No-Chicken/OV-Card/Software/OV_CardV1/主图片.jpg

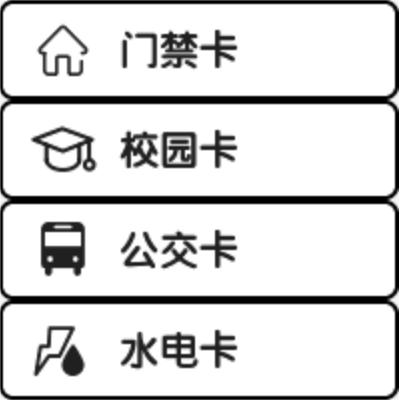
Software/OV_CardV1/主图片.jpg
