No-Chicken/OV-Card/3D Model/外壳零件.STL

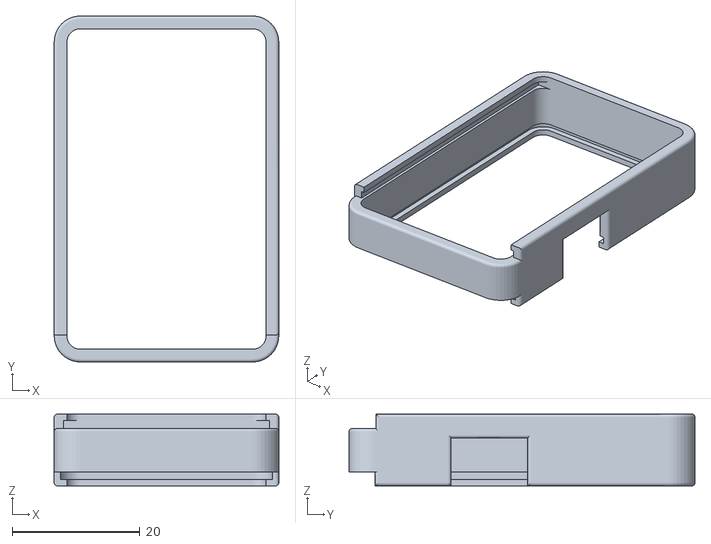
[picture p6: CAD file, 2023-08-09]
3D Model/外壳零件.STL
35.2 x 54.2 x 11.2
