No-Chicken/OV-Card/3D Model/下盖零件.STL

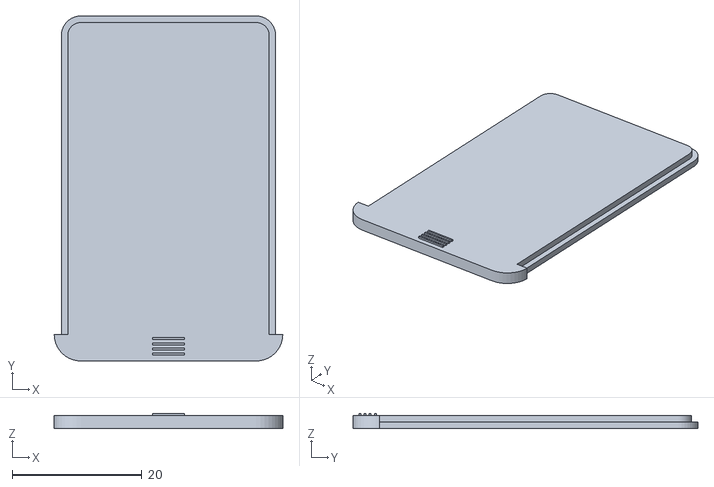
[picture p7: CAD file, 2023-08-09]
3D Model/下盖零件.STL
35.2 x 53.1 x 2.30
