No-Chicken/OV-Card/Hardware/SCH_Schematic1_2023-07-31.pdf

# VDD 17 PA8 18 PA9 19 PA10 20 PA11 21 PA12 22 PA13 23 PA14 24

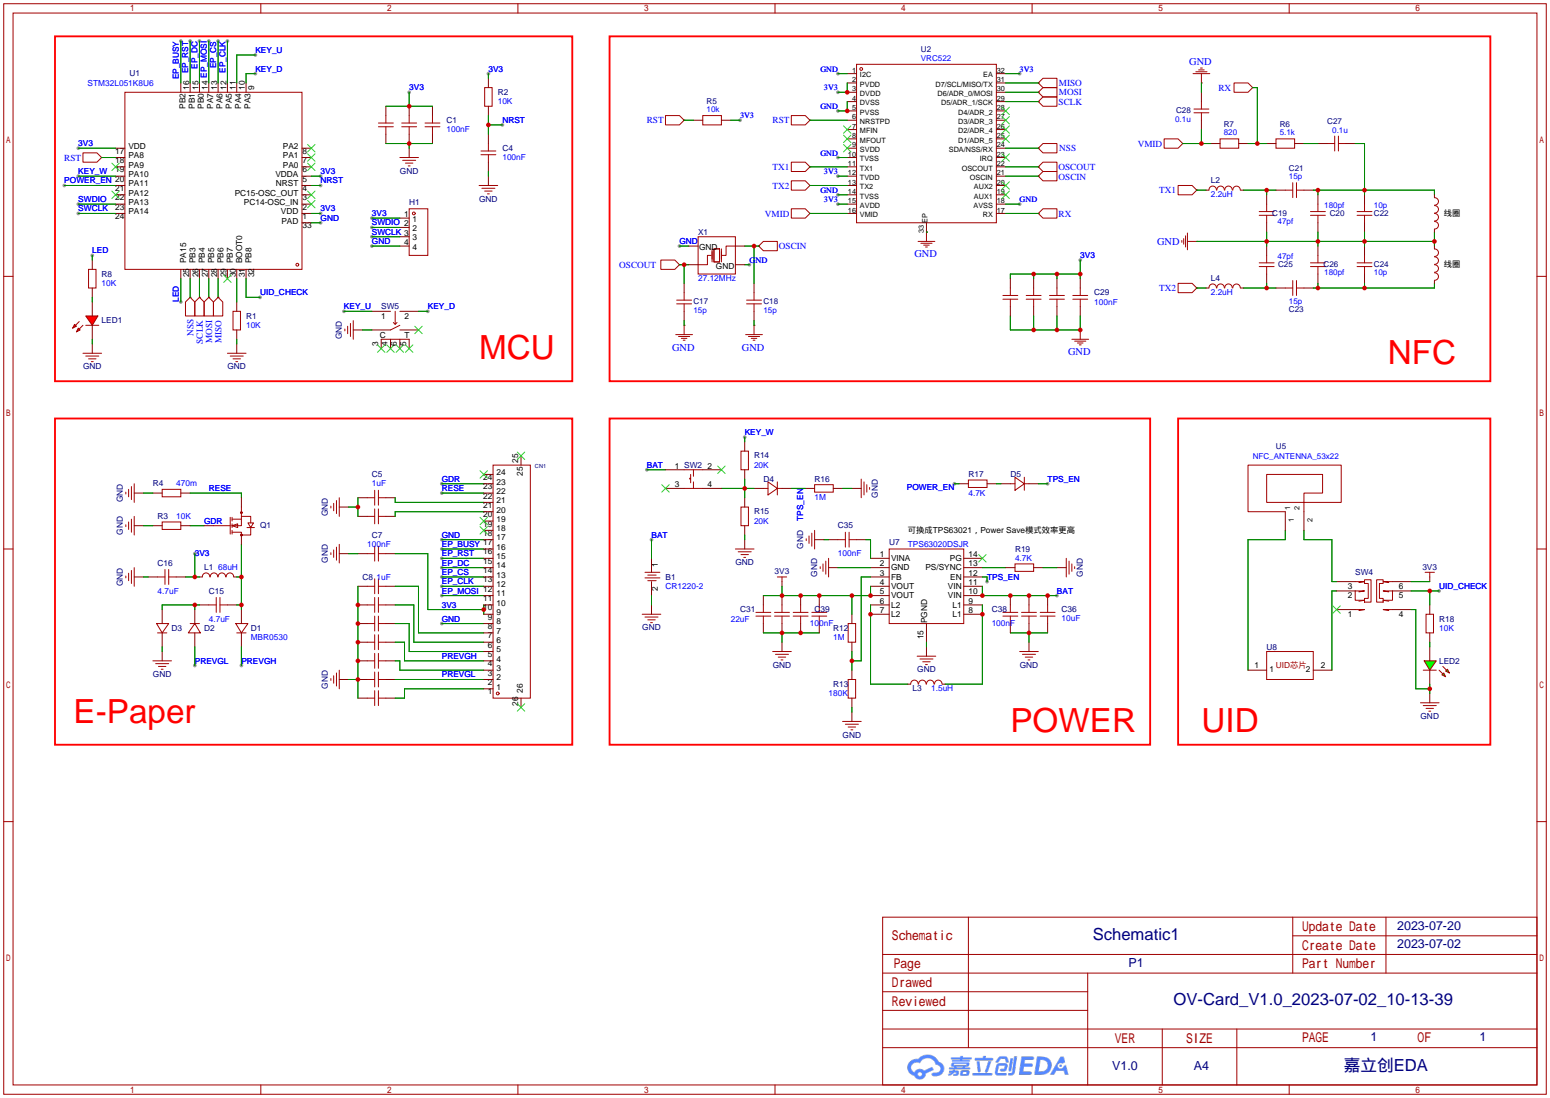
[picture p8: page 1]

VIN 10 VIN 11 EN 12 PS/SYNC 13 PG 14 PGND 15
