No-Chicken/OV-Card/Software/OV_CardV1_LP/Core/Src/main.c

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
/* Includes ------------------------------------------------------------------*/
#include "main.h"
#include "gpio.h"

/* USER CODE BEGIN Includes */
#include "RC522.h"
#include "key.h"
#include "EEPROM.h"
/* USER CODE END Includes */


/* USER CODE BEGIN PV */

uint8_t RC522_ERRO = 1;
uint8_t EEPROM_ERRO = 1;

/* USER CODE END PV */

void SystemClock_Config(void);
/* USER CODE BEGIN 0 */
unsigned char snr, TagType[2], SelectedSnr[4], DefaultKey[6] = {0xFF, 0xFF, 0xFF, 0xFF, 0xFF, 0xFF};
/* USER CODE END 0 */

/**
  * @brief  The application entry point.
  * @retval int
  */
int main(void)
{
  /* USER CODE BEGIN 1 */
	
	uint8_t status;
	uint8_t read_buf[16];
	uint8_t data_addr;
	uint8_t cuid_flag = 1;
  /* USER CODE END 1 */

  /* MCU Configuration--------------------------------------------------------*/

  /* Reset of all peripherals, Initializes the Flash interface and the Systick. */
  HAL_Init();

  /* Configure the system clock */
  SystemClock_Config();

  /* Initialize all configured peripherals */
  MX_GPIO_Init();
  /* USER CODE BEGIN 2 */
	HAL_GPIO_WritePin(GPIOA,LED6_Pin|LED5_Pin|LED4_Pin,GPIO_PIN_RESET);
	HAL_GPIO_WritePin(GPIOB,LED1_Pin|LED2_Pin|LED3_Pin,GPIO_PIN_RESET);
	
	key_port_init();	
	
	RC522_Port_Init();
	RC522_PowerOff();
	
	if(!EEPROM_Read_W_CHECK(0x00,read_buf,2))
	{
		if(read_buf[0] == 0x55 && read_buf[1] == 0xAA)
		{
			EEPROM_ERRO = 0;
			EEPROM_Read_W_CHECK(DATA_ADDR_ADDR,&data_addr,1);
		}
		else//first use
		{
			read_buf[0] = 0x55;
			read_buf[1] = 0xAA;
			read_buf[2] = 0x10;
			EEPROM_ERRO = EEPROM_Write_W_CHECK(0,read_buf,3);
		}
	}
	
	HAL_GPIO_WritePin(GPIOA,GPIO_PIN_15,GPIO_PIN_SET);
  /* USER CODE END 2 */

  /* Infinite loop */
  /* USER CODE BEGIN WHILE */
  while (1)
  {
    /* USER CODE END WHILE */

    /* USER CODE BEGIN 3 */
		
		/*****************Key Scan*****************/
		uint8_t key;
		key = KeyScan(0);
		if(key == 1)
		{
			data_addr -= 0x10;//data_addr --, change to previous UID
			if(data_addr<0x10)
				data_addr = 0x10*ID_NUM;
			HAL_GPIO_WritePin(UID_Check_GPIO_Port,UID_Check_Pin,GPIO_PIN_SET);
			if(!EEPROM_ERRO)
			{
				EEPROM_Write_W_CHECK(DATA_ADDR_ADDR,&data_addr,1);
			}
			cuid_flag = 1;
			HAL_GPIO_WritePin(GPIOA,LED6_Pin|LED5_Pin|LED4_Pin,GPIO_PIN_RESET);
			HAL_GPIO_WritePin(GPIOB,LED1_Pin|LED2_Pin|LED3_Pin,GPIO_PIN_RESET);
		}
		else if(key == 2)
		{
			data_addr += 0x10;//data_addr add, change to next UID
			if(data_addr>(0x10*ID_NUM))
				data_addr = 0x10;
			HAL_GPIO_WritePin(UID_Check_GPIO_Port,UID_Check_Pin,GPIO_PIN_SET);
			if(!EEPROM_ERRO)
			{
				EEPROM_Write_W_CHECK(DATA_ADDR_ADDR,&data_addr,1);
			}
			cuid_flag = 1;
			HAL_GPIO_WritePin(GPIOA,LED6_Pin|LED5_Pin|LED4_Pin,GPIO_PIN_RESET);
			HAL_GPIO_WritePin(GPIOB,LED1_Pin|LED2_Pin|LED3_Pin,GPIO_PIN_RESET);
		}
		/******************************************/
		
		
		/*********check the ID Change and turn the LED**************/
		uint8_t temp = data_addr>>4 & 0x0f;
		//temp = temp>>4 & 0x0F;
		switch(temp)
		{
			case 1:
				HAL_GPIO_WritePin(GPIOB,LED1_Pin,GPIO_PIN_SET);
				break;
			case 2:
				HAL_GPIO_WritePin(GPIOB,LED2_Pin,GPIO_PIN_SET);
				break;
			case 3:
				HAL_GPIO_WritePin(GPIOB,LED3_Pin,GPIO_PIN_SET);
				break;
			case 4:
				HAL_GPIO_WritePin(GPIOA,LED4_Pin,GPIO_PIN_SET);
				break;
			case 5:
				HAL_GPIO_WritePin(GPIOA,LED5_Pin,GPIO_PIN_SET);
				break;
			case 6:
				HAL_GPIO_WritePin(GPIOA,LED6_Pin,GPIO_PIN_SET);
				break;
		}
		/***********************************************************/
		
		
		/*********check the CUID card is selected or not************/
		if(HAL_GPIO_ReadPin(GPIOB,GPIO_PIN_8))//the UID card is selected
		{
			if(cuid_flag)
			{
				RC522_ERRO = RC522_Init();
				/*************write the cuid************/
				status= PcdRequest(REQ_ALL,TagType);
				if(!status)
				{
					status = PcdAnticoll(SelectedSnr);
					if(!status)
					{
						status=PcdSelect(SelectedSnr);
						if(!status)
						{
							snr = 0;  //sector 0
							status = PcdAuthState(KEYA, (snr*4+3), DefaultKey, SelectedSnr);
							{
								if(!status)
								{
									if(!EEPROM_ERRO)
									{
										EEPROM_Read_W_CHECK(data_addr,read_buf,16);
									}
									status = PcdWrite((snr*4+0), read_buf);  
									if(!status)
									{
										HAL_GPIO_WritePin(GPIOA,GPIO_PIN_15,GPIO_PIN_SET);
										cuid_flag = 0;
										//WaitCardOff();
										HAL_GPIO_WritePin(GPIOA,GPIO_PIN_15,GPIO_PIN_RESET);
										RC522_PowerOff();
									}
								}
							}
						}
					}
				}
				/***************************************/
			}
		}
		else	//the UID card is disabled
		{
			/***********search the card***************/
			if(cuid_flag)
			{
				RC522_ERRO = RC522_Init();
				status= PcdRequest(REQ_ALL,TagType);
				if(!status)
				{
					status = PcdAnticoll(SelectedSnr);
					if(!status)
					{
						status=PcdSelect(SelectedSnr);
						if(!status)
						{
							snr = 0;  //sector 0
							status = PcdAuthState(KEYA, (snr*4+3), DefaultKey, SelectedSnr);
							{
								if(!status)
								{
									status = PcdRead((snr*4+0), read_buf);  
									if(!status)
									{
										HAL_GPIO_WritePin(GPIOA,GPIO_PIN_15,GPIO_PIN_SET);
										//WaitCardOff();
										if(!EEPROM_ERRO)
										{
											EEPROM_Write_W_CHECK(data_addr,read_buf,16);
										}
										HAL_GPIO_WritePin(GPIOA,GPIO_PIN_15,GPIO_PIN_RESET);
										//return 0;
										RC522_PowerOff();
										cuid_flag = 0;
									}
								}
							}
						}
					}
				}
			}
			/****************************************/
		}
		/***********************************************************/

  }
  /* USER CODE END 3 */
}

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
