No-Chicken/OV-Card/Software/OV_CardV1_LP/Core/Inc/main.h

#define LED6_Pin GPIO_PIN_5
#define LED6_GPIO_Port GPIOA
#define LED5_Pin GPIO_PIN_6
#define LED5_GPIO_Port GPIOA
#define LED4_Pin GPIO_PIN_7
#define LED4_GPIO_Port GPIOA
#define LED3_Pin GPIO_PIN_0
#define LED3_GPIO_Port GPIOB
#define LED2_Pin GPIO_PIN_1
#define LED2_GPIO_Port GPIOB
#define LED1_Pin GPIO_PIN_2
#define LED1_GPIO_Port GPIOB
#define LED_Test_Pin GPIO_PIN_15
#define LED_Test_GPIO_Port GPIOA
#define UID_Check_Pin GPIO_PIN_8
#define UID_Check_GPIO_Port GPIOB
